ZenithControlLabs/Phobri64_HW/extras/braindump/v1.md

Main board Image:
X: 181.228
Y: 96.268
Scale: 0.999166

Stick board image:
X: 179.699869
Y: 112.95598
Scale: 0.999165
