ZenithControlLabs/Phobri64_HW/extras/braindump/proto.md

- Add a button footprint for start & dpad
- Fix the button footprint for face buttons (way too close rn)
- Make the stick footprints
- Make the L/R header footprints

notes:

Hori start/dpad ~ 4.7625mm
Hori ABC ~ 6.35

Stick PCB
Height: 33.45 mm
Width: 45.2 mm
big diagonal hyp: 17.5

main pcb: 65.45

38.270

50.628
83.185
17.889

54.8 width

Start: 23mm from top, aligned with dpad up horizontall
Dpad up/down: 13mm from side
dpad right: 6.8mm from side
dpad left: 21mm
dpad left/right: 10.3mm from bottom
top: 17.2mm from bottom
bottom: 3.4mm from bottom
243.39833
8.166

-33.373692
123.954918
1.5

1.603122

-66.084568
123.997083

-33.373692
123.954918

-54.586048
123.988748

-44.888743
124.044034

Move halls slightly closer to the stickbox?
Add a 3D model for the JST connector?
Fix all the ground issues
Review trace lengths
Add actually useful silkscreens for connectors
F.Fab
