ZenithControlLabs/Phobri64_HW/Phobri64/Phobri64_3Dmodels/5017.step

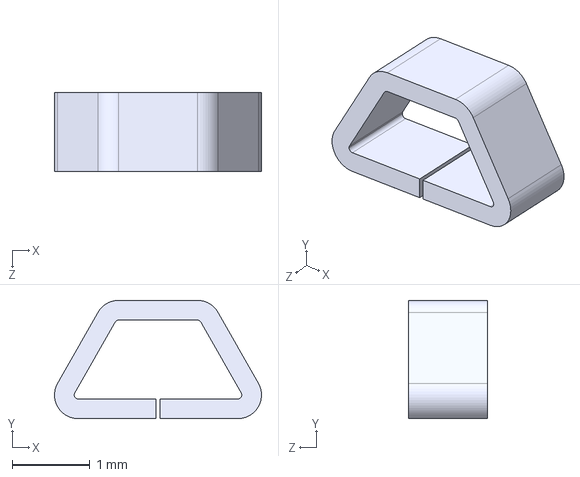
[picture p1: CAD file, 2023-09-23]
Phobri64/Phobri64_3Dmodels/5017.step
2.67 x 1.52 x 1.02 mm
