ZenithControlLabs/Phobri64_HW/Phobri64/Phobri64_3Dmodels/B3B-EH-A.STEP

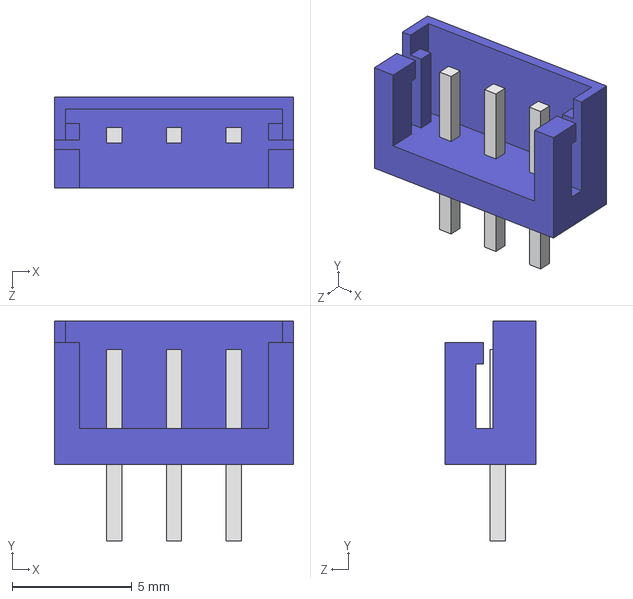
[picture p2: CAD file, 2023-09-23]
Phobri64/Phobri64_3Dmodels/B3B-EH-A.STEP
10.0 x 9.20 x 3.80 mm
