ZenithControlLabs/Phobri64_HW/Phobri64/Phobri64_3Dmodels/TS-1187A.step

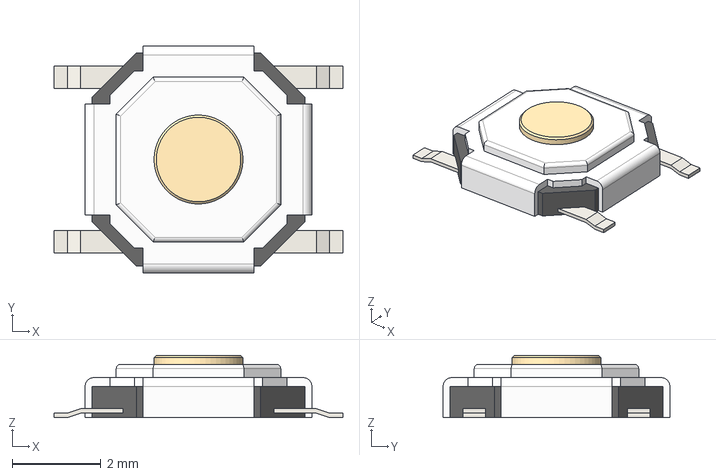
[picture p3: CAD file, 2023-09-23]
Phobri64/Phobri64_3Dmodels/TS-1187A.step
6.50 x 5.10 x 1.40 mm
