ZenithControlLabs/Phobri64_HW/Phobri64/Phobri64_3Dmodels/1mm_cube.step

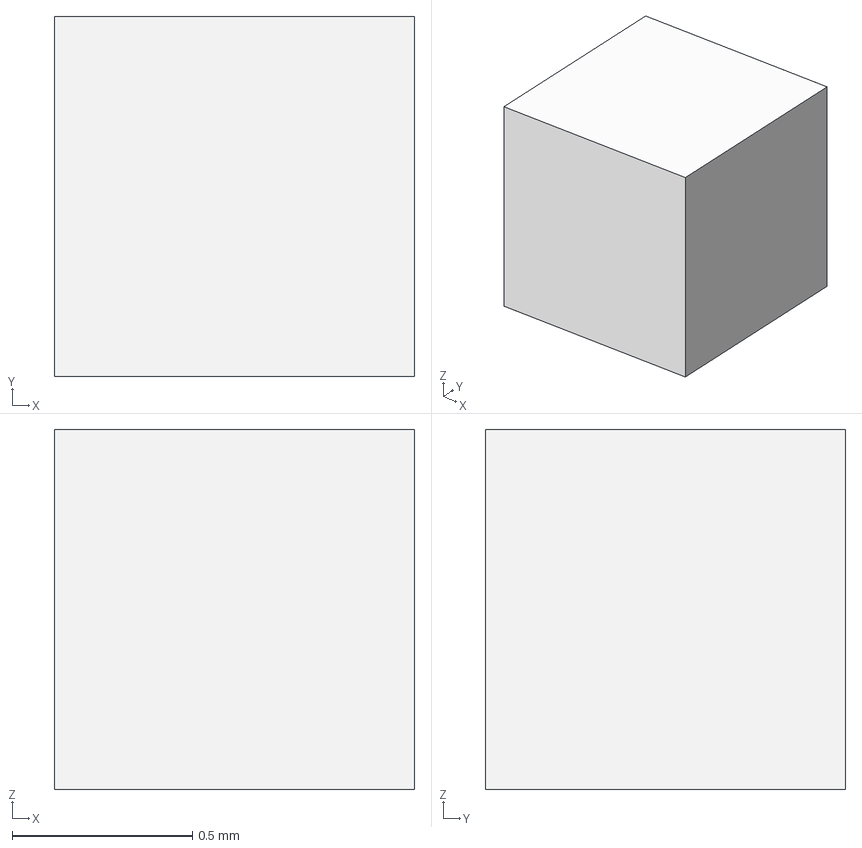
[picture p4: CAD file, 2023-09-23]
Phobri64/Phobri64_3Dmodels/1mm_cube.step
1.00 x 1.00 x 1.00 mm
