ZenithControlLabs/Phobri64_HW/Phobri64/Phobri64_3Dmodels/RUG0010A.stp

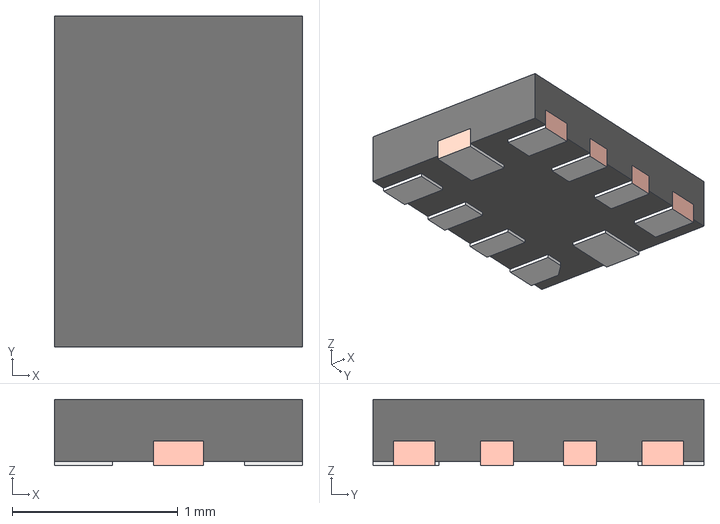
[picture p5: CAD file, 2023-09-23]
Phobri64/Phobri64_3Dmodels/RUG0010A.stp
1.50 x 2.00 x 0.4 mm
FRAME_RUG0010A
BODY_RUG0010A
