ZenithControlLabs/Phobri64_HW/Phobri64/Phobri64_3Dmodels/B10B-PHDSS.STEP

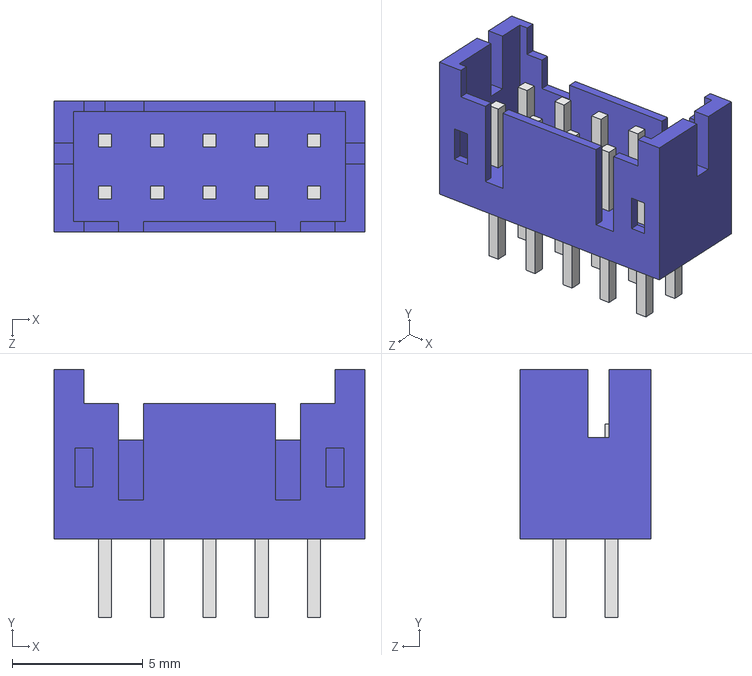
[picture p6: CAD file, 2023-09-23]
Phobri64/Phobri64_3Dmodels/B10B-PHDSS.STEP
11.9 x 9.50 x 5.00 mm
