ZenithControlLabs/Phobri64_HW/Phobri64/Phobri64_3Dmodels/WSON-8_6X5_WIN.step

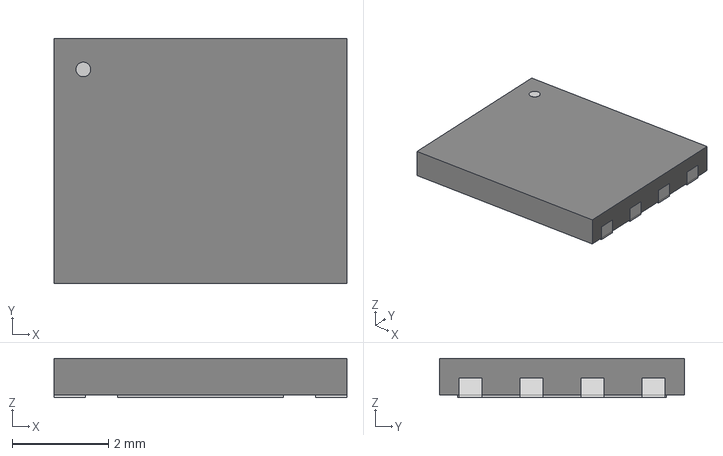
[picture p7: CAD file, 2023-06-08]
Phobri64/Phobri64_3Dmodels/WSON-8_6X5_WIN.step
6.10 x 5.11 x 0.815 mm
