ZenithControlLabs/Phobri64_HW/Phobri64/Phobri64_3Dmodels/dpad_debugbtn.step

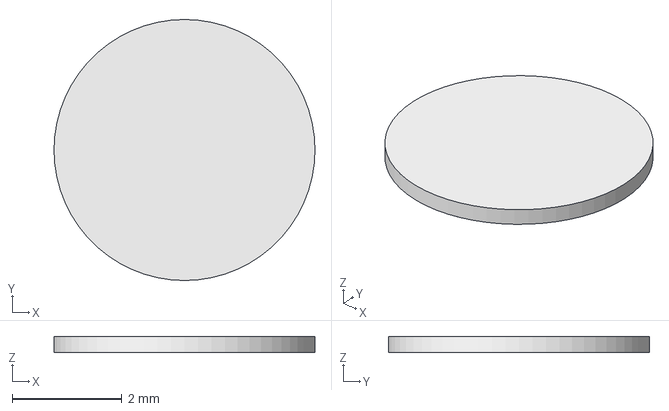
[picture p8: CAD file, 2023-06-08]
Phobri64/Phobri64_3Dmodels/dpad_debugbtn.step
4.76 x 4.76 x 0.3 mm
