ZenithControlLabs/Phobri64_HW/Phobri64/Phobri64_3Dmodels/abc_debugbtn.step

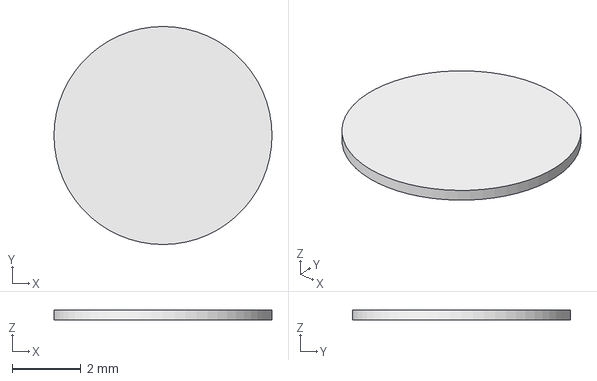
[picture p9: CAD file, 2023-06-08]
Phobri64/Phobri64_3Dmodels/abc_debugbtn.step
6.36 x 6.36 x 0.3 mm
