ZenithControlLabs/Phobri64_HW/(threads)

Thread 2 (2023-06-21):

Fix known alpha1 issues

panther03, 2023-06-21:
Fix the known issues in alpha1. List so far:

- N64 JST connector pinout is flipped (only the pinout, not the connector itself)
- Mounting hole is off
- Pitch on paddle headers is way too small and the holes are also way too small

Closed 2023-08-05.

Thread 5 (2023-07-08):

Add github link to pcb silkscreen

panther03, 2023-07-08:
Mandatory for cern OHW:
> You may Make Products, and/or Convey them, provided that You either provide each recipient with a copy of the Complete Source or ensure that each recipient is notified of the Source Location of the Complete Source

panther03, 2023-08-24:
Addressed in v1.X, commit 12677b7

Closed 2023-08-24.

Thread 7 (2023-07-08):

Switch to Mitch's USBC breakout

panther03, 2023-07-08:
Instead of a separate port for N64 and USB, switch to using the USB C breakout cable when it comes out.

panther03, 2023-08-24:
Decision has been made to move to a USB-C port in place of the old mini-USB connector.
This port will have the N64 pins previously provided by the breakout cable routed to the same pins.

Closed 2023-08-24.

Thread 8 (2023-07-08):

Use scanner to get Hori board layout

panther03, 2023-07-08:
The current board design was based off a picture taken of the board with some attempt at perspective correction applied. Holes were adjusted based on trial and error. Better results could probably be achieved using a flatbed scanner and a bare hori motherboard. This could reclaim some mm of space on the board because the current design is a little smaller than a stock motherboard.

panther03, 2023-07-10:
Use Wermi's existing scans to get these. Since she didn't scan the back of it (or did she?) we might need to move around button placements. They can probably be placed by trial and error with the initial guess being based on lining up the current design with the oem board on some corner (for example, bottom right). Then, we would just keep the button placements in tact.

panther03, 2023-08-24:
Wermi's scans incorporated for v1.X; did basic 3d print testing and seems to work fine.
![Uploading image.png…]()

Closed 2023-08-24.

Thread 9 (2023-07-08):

Switch to a smaller QSPI flash part and move it out

panther03, 2023-07-08:
The QSPI flash on the current design sits at the exposed expansion pak port by the USB:

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

I can't imagine this is doing the controller any favors for reliability, even though it's not strictly speaking a problem electrically or mechanically.  The point is that there are smaller form factor QSPI flash parts that would probably be easier to layout for. They also happen to be smaller in capacity but we don't have a large need for capacity (this current part is 128Mb, something like 16Mb would still be plenty).

Plus, if we decide to get rid of that USB port in #7, having anything there will be a problem.

panther03, 2023-08-01:
Found a smaller part: W25Q16JVUXIQ (USON-8 package). Working to place & route with new design.

panther03, 2023-08-24:
USON part locked in for v1.X, can be closed now.

Closed 2023-08-24.

Thread 14 (2023-09-09):

I2C pin placement is invalid on RP2040

panther03, 2023-09-09:
The v1.X schematic currently has SDA and SCL on GPIO pins 17 and 18 of the rp2040 respectively:
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
However, the RP2040 does not have the proper I2C configuration on these pins:
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
Pin 17 is SCL for I2C0, while pin 18 is SDA for I2C1.

**The pins need to be adjusted to be on one peripheral with the right assignments.**

[RP2040 Pin Reference](https://www.circuitstate.com/pinouts/raspberry-pi-pico-microcontroller-board-pinout-diagrams/#I2C)

panther03, 2023-09-18:
Fixed I2C pin assignment in schematic in 024530d6fc08bbf6c054ec8122155a7af49e8da2, re-layout still pending?

panther03, 2023-09-24:
Fixed in f2a6f2cd7c507b86680466e1e35eed12c4cfaf11.

Closed 2023-09-24.

Thread 15 (2023-09-09):

Debug UART pins invalid

panther03, 2023-09-09:
in v1.X DEBUG_TX (UART) is on GPIO pin 26, which is only GPIO or ADC.
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
Discord link: https://discord.com/channels/1050259430182244404/1142853140832600074/1148904799119618139

**Note: RX is a nice-to-have, not a requirement**

[RP2040 pin reference](https://www.circuitstate.com/pinouts/raspberry-pi-pico-microcontroller-board-pinout-diagrams/#UART)

panther03, 2023-09-18:
As of 024530d6fc08bbf6c054ec8122155a7af49e8da2, UART is its own full header, but TX specifically is on pin 24 which is in fact UART1 TX.

Closed 2023-09-18.
