ZenithControlLabs/Phobri64_HW/(commit log)

2023-06-17 stick daughterboard adjustments
    [Phobri64.kicad_pcb, Phobri64.kicad_sch]
2023-06-21 Stickboard refinements; widen some traces and move silkscreens
    [Phobri64.kicad_pcb]
2023-06-21 repo cleanup, addresses #1
    [ImageToStl.com_phobri64.stl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]
2023-06-24 #2 address alpha1 issues
    [Phobri64.kicad_pcb, Phobri64.kicad_sch]
2023-06-24 Fix DRC
    [Phobri64.kicad_pcb]
2023-07-14 odds and ends for starting v1 work
    [Phobri64.kicad_sch]
2023-08-01 components placed according to wermi board pics
    [Phobri64.kicad_pcb, Phobri64.kicad_sch]
2023-08-05 Resolve most of the main board routing
    [Phobri64.kicad_pcb]
2023-08-05 3D models and slight routing fixes
    [Phobri64.kicad_pcb]
2023-08-07 Switch to I2C sensors + ADC+THT halls
    [Phobri64.kicad_pcb, Phobri64.kicad_sch]
2023-08-07 Review notes
    [Phobri64.kicad_pcb]
2023-08-09 Implememnt design review changes in schematic
    [5017.step, Phobri64.kicad_pcb, Phobri64.kicad_sch]
2023-08-12 Change ADC & wire up new stickboard ADS1115 -> ADS7142
    [Phobri64.kicad_pcb, Phobri64.kicad_sch, RUG0010A.stp]
2023-08-16 Various layout tasks, some schematic updates
    [Phobri64.kicad_pcb, Phobri64.kicad_sch]
2023-08-18 Fix USB-C 10pin header pinout
    [Phobri64.kicad_pcb, Phobri64.kicad_sch]
2023-08-19 Schematic ready for review; need to update PCB
    [B10B-PHDSS.STEP, B3B-EH-A.STEP, Phobri64.kicad_pcb, Phobri64.kicad_sch, TS-1187A.step]
2023-08-19 addressing layout updates
    [Phobri64.kicad_pcb, Phobri64.kicad_sch]
2023-08-20 Ready for review
    [Phobri64.kicad_pcb, Phobri64.kicad_sch]
2023-08-20 Add pin 1 designators for JLC & fix BOM
    [Phobri64.kicad_pcb, Phobri64.kicad_sch]
2023-08-20 Move over ADC a bit for stickbox clearance
    [Phobri64.kicad_pcb]
2023-08-23 Address review changes for schematic
    [Phobri64.kicad_pcb, Phobri64.kicad_sch]
2023-08-23 add silkscreens for instructions/builder comments
    [Phobri64.kicad_pcb]
2023-08-24 Adding testpoints as described
    [Phobri64.kicad_sch]
2023-08-24 fanout complete, most of schematic is done
    [Phobri64.kicad_pcb, Phobri64.kicad_sch]
2023-08-26 main board layout done. Silkscreen not done. Makers mark not done. Stick board not done. RFC
    [Phobri64.kicad_pcb, Phobri64.kicad_sch]
2023-08-27 Cleaned up and locked edge-cuts layer
    [Phobri64.kicad_pcb, Phobri64.kicad_sch]
2023-08-27 copper should be done at this point. Silkscreen to go
    [Phobri64.kicad_pcb, Phobri64.kicad_sch]
2023-08-29 cleanup schematic, add circle silkscreen to stickboard
    [Phobri64.kicad_pcb, Phobri64.kicad_sch]
2023-09-03 Cleanup silkscreens on mainboad; still needs logo
    [Phobri64.kicad_pcb]
2023-09-06 Fix holes in THT sensor footprint & add silkscreen logo
    [Phobri64.kicad_pcb]
2023-09-14 Update silkscreen logo
    [Phobri64.kicad_pcb]
2023-09-18 some issues addressed
    [Phobri64.kicad_pcb, Phobri64.kicad_sch]
2023-09-18 Clean up silkscreens & footprints
    [1mm_cube.step, Phobri64.kicad_pcb, Phobri64.kicad_sch]
2023-09-18 Fixes for JLCPCB
    [Phobri64.kicad_pcb, Phobri64.kicad_sch]
2023-09-22 I2C fixed, B button fixed, ground fill cleanup
    [Phobri64.kicad_pcb]
2023-09-22 DRC cleanup; Schematic review
    [Phobri64.kicad_pcb, Phobri64.kicad_sch]
2023-09-23 Fixed and touched up some copper.
    [Phobri64.kicad_pcb]
2023-09-23 POS file fixes
    [Phobri64.kicad_pcb]
2023-09-23 Update source files silkscreen
    [Phobri64.kicad_pcb]
2023-09-24 Last minute info text fixes
    [Phobri64.kicad_pcb]
2024-04-27 switch to single 3d hall sensor
    [Phobri64.kicad_pcb, Phobri64.kicad_sch]
2024-05-04 add potentiometer footprints
    [Phobri64.kicad_pcb, Phobri64.kicad_sch]
2024-06-09 First draft of new board design RFC
    [Phobri64.kicad_pcb, Phobri64.kicad_sch]
2024-06-09 Final touchups
    [Phobri64.kicad_pcb, Phobri64.kicad_sch]
2024-06-09 upgrade kicad containers
2024-06-09 fix drc error
    [Phobri64.kicad_pcb]
2024-06-12 Clean up for elecrow export; bump version
    [Phobri64.kicad_pcb, Phobri64.kicad_sch]
2024-06-16 Changes the design rules to line up with the new fab, and made adjustments to both boards to make them follow the minimums
    [Phobri64.kicad_pcb]
2024-06-23 suppress drc
    [Phobri64.kicad_pcb]
2024-11-09 first pass simplifying the stick board
    [Phobri64.kicad_pcb, Phobri64.kicad_sch]
2024-11-09 Add TVS diode for power protection
    [Phobri64.kicad_pcb, Phobri64.kicad_sch]
2024-11-09 Added ESD mitigation diodes to main board
    [Phobri64.kicad_pcb, Phobri64.kicad_sch]
2024-11-13 Add footprint for 10P connector
    [Phobri64.kicad_pcb, Phobri64.kicad_sch]
2024-11-18 first pass routing PCB with ESD protection and neew old connectors
    [Phobri64.kicad_pcb, Phobri64.kicad_sch]
2024-11-18 Added missing esd mitigation to stick board, cleaned up some routing
    [Phobri64.kicad_pcb, Phobri64.kicad_sch]
2024-11-19 start silkscreens
    [Phobri64.kicad_pcb]
2024-11-21 moved stickboard components to respect the case keepout zone. Changed some gpio layout
    [Phobri64.kicad_pcb, Phobri64.kicad_sch]
2024-11-24 Finish silkscreens
    [Phobri64.kicad_pcb]
2024-11-24 Update BOM & schematic
    [Phobri64.kicad_sch]
2024-11-24 f silkscreen touchups
    [Phobri64.kicad_pcb, Phobri64.kicad_sch]
2024-11-24 b silkscreen additions
2024-11-24 Missed one b silkscreen element
    [Phobri64.kicad_pcb]
2024-11-24 more touchups on silkscreens
    [Phobri64.kicad_pcb]
2024-11-24 update testing guide
    [Phobri64.kicad_pcb]
2024-11-25 Moved a TVS diode, touched up some more routing and silk screening
    [Phobri64.kicad_pcb, Phobri64.kicad_sch]
2024-12-07 attempt to add cardosi trigger boards
    [Phobri64.kicad_pcb]
2024-12-07 remove stickboard 2 trigger mousebite connection; fix drc
    [Phobri64.kicad_pcb]
2024-12-08 fixed trigger boards
    [Phobri64.kicad_pcb, Phobri64.kicad_sch]
2024-12-09 silence, DRC
    [Phobri64.kicad_pcb]
2024-12-09 exclude trigger board things from position files
    [Phobri64.kicad_pcb]
2025-04-02 Doubled thermal relief and made shoulder solder headers more rip resistent
    [Phobri64.kicad_pcb, Phobri64.kicad_sch]
2025-04-27 add silkscreens for pcb sides
    [Phobri64.kicad_pcb]
2025-05-03 adding support for 13mm sticks using a combined footprint
    [Phobri64.kicad_pcb, Phobri64.kicad_sch]
2025-05-31 Add original hori stickbox compatible footprint
    [Phobri64.kicad_pcb]
2025-06-08 Cleaned up new stickbox footprint and re-routed stick ADC to accomodate it.
    [Phobri64.kicad_pcb, Phobri64.kicad_sch]
2025-06-11 Touch up silkscreens
    [Phobri64.kicad_pcb, Phobri64.kicad_sch]
