ZenithControlLabs/Phobri64_HW/(notices)

Notices in the files:
Phobri64/Phobri64.kicad_pcb:
Licensed under
CERN-OHL-S v2
